DEFOR111/MADHEX-v2/Electronics/renders/PCB BOTTOM.png

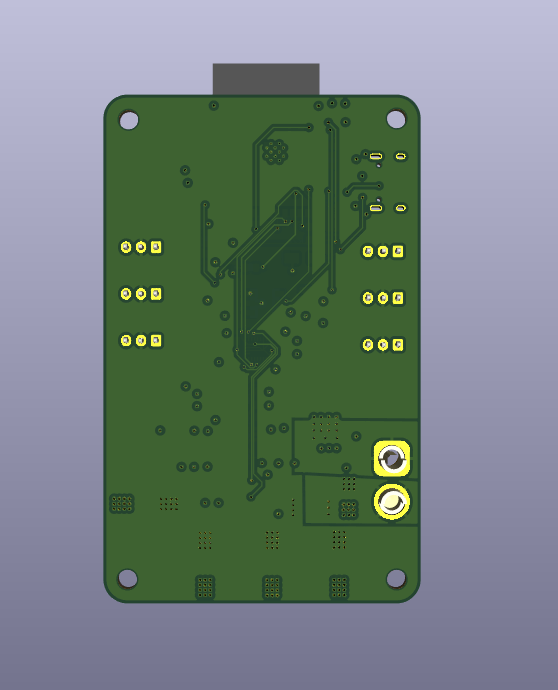
Electronics/renders/PCB BOTTOM.png
