DEFOR111/MADHEX-v2/Electronics/renders/PCB TOP VIEW.png

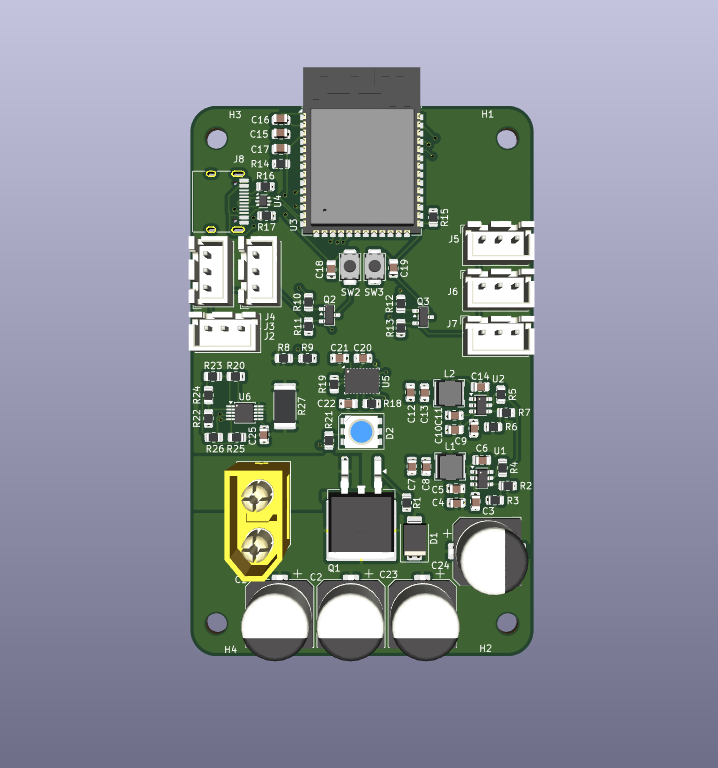
Electronics/renders/PCB TOP VIEW.png
