DEFOR111/MADHEX-v2/README.md

# ***MADHEX-v2***
> ## the Fully open source 6 legged hexapod robot 


* Custom controller PCB
* Fully open-source
* great mechanics design with amortization
#### the 18DOF hexapod robot 

## the README include 
* Overwiew
* Features
* Electronics
* CAD
* firmware
* BOM

# Overview 
MadHex v2 is an open-source hexapod robot designed for people who wanna build their spider friend and learn building — CAD, PCB , and design  are all custom-made. This repository contains everything needed to reproduce the robot: CAD source and manufacturing files, PCB design and production files, bill of materials

Currently the project is in procces of building 

# Features

* Fully custom mechanical design , all parts are 3d printable
* custom control PCB : schematics , 4 layer of layout , kicad project , and manufactoring files
* 2 Full BOM files for both PCB and Robot
* great design with beatiful decisions

 # Electronics PCB 
 ### The schematics 


### the renders
PCB LAYER F CU

PCB TOP

Custom 4-layer control board 

**Key Features :**

* **MCU:** ESP32-S3-WROOM-1 — great wifi/bluetooth MCU 
* **IMU:** BNO055  — 9-DOF orientation for balancing
* **Power input:** XT60 connector - for battery connection 
* **Power protection:** low-side N-MOSFET reverse-polarity protection NTMFS5C404NL + SMBJ10CA TVS diode + 30A fuse
* **Regulation:** two TPS563201 buck converters: battery → 5.3V → Schottky → 5V rail → 3.3V
* **USB power path:** Schottky diodes keep USB and the battery side separated
* **Power monitoring:** INA226 current/voltage sensor (I2C) with a 2m shunt + analog voltage divider as backup 
* **USB-C:**  USB with USBLC6-2P6 ESD protection
* **Status LED:**  WS2812 RGB
* **Servo interface:** 2× independent half-duplex UART buses , 3 legs per bus — driving serial bus servos over a single data line per bus instead of  PWM channels
* **Connectors:** 6 3-pin leg connectors (J2–J7), one per leg makes the wiring a lot easier 

**Files:**
* Schematic: [download the schematics](Electronics/Hexapod%20PCB%202.pdf)
* Gerbers + drill files : [Download the manufactoring files](Electronics/manufactoring%20files.zip)
* BOM: [download the PCB BOM](BOM-PCB.csv)

**Board spec:**

| Spec | Value |
|---|---|
| Layers | 4 |
| MCU | ESP32-S3-WROOM-1 |
| Logic  | 3.3V |
| Peripheral  | 5V |
| Servo buses | 2× half-duplex UART (3 legs each) |
| Power input | XT60 |
| Current sensing | INA226 |

# CAD

Fully custom mechanical design, designed in autodesk Fusion every part is 3D-printable 



**values:**

| Spec | Value |
|---|---|
| size | 600 × 175 mm |
| DOF per leg | 3 (coxa – femur – tibia) |
| Total DOF | 18 |
| Coxa (axis to axis) | 45 mm |
| Femur (axis to axis) | 128 mm |
| Tibia (knee axis to foot tip) | 141.8 mm straight line, 168.5 mm along the curved part |
| Actuators | LX-16A serial bus servo, 17 kg·cm at 6V / 19.5 kg·cm at 7.4V (×18) |

Segment lengths were chosen using the servo torque  

**3D printing:**

| Spec | Value |
|---|---|
| Material | PETG |
| Total printed weight | ~878–950 g (all parts, with supports) |
| Parts | download [3d printing STL parts ](CAD/STL(3d%20printing%20parts)) |

PETG was chosen over PLA for better impact resistance sustained servo load — legs take repeated ground-impact stress during walking.

**Foot amortization (printed spring):**

Each foot includes a printed compliant spring element (PETG) acting as a passive shock absorber — it absorbs ground-impact impulse on footfall instead of transmitting it directly into the leg linkage/servo horn, reducing mechanical stress and jitter during walking.

**Files:**

| Format | Path | Use case |
|---|---|---|
| `.f3d` / `.f3z` | [autodesk fusion source file](CAD/source(f3d)) | Editable native Fusion source |
| `.step` | [full robot design universal file](CAD/step) | Full assembly + parts, universal format |
| `.stl` | [3d printing files](CAD/STL(3d%20printing%20parts)) | ready to slice |
| Renders | [photos of the CAD](CAD/renders) | Reference images |

Full parts list, printed vs. purchased components, and quantities: [see the main BOM](BOM%20main.csv)

# Bill of Materials

Two separate BOMs are provided — one for the full robot, one for the PCB only.

### Full Robot BOM

Full file: [see the full main BOM](BOM%20main.csv)

| Item | Qty | Description | Price |
|---|---|---|---|
| PCB | 1 | Custom PCB, UART servo controller — see [PCB BOM](BOM-PCB.csv) below | $50.10 |
| LX-16A | 18 | Serial bus UART servo, 17 kg·cm @6V / 19.5 kg·cm @7.4V | $252.00 |
| Battery | 1 | 6000mAh 2S, 7.4–8.4V, ≥30A discharge | $29.70 |
| Auto Fuse + holder | 1 | 30A safety fuse | $5.31 |
| XT60 | 1 | Pack of male/female connectors | $2.00 |
| Power wire | — | Silicone 14 AWG, battery → PCB | — |
| PETG | 900g | Filament for 3D-printed parts (min. 900g) | — |
| M3 screws | pack | Structural assembly | — |
| M3×5 inserts | pack | Heat-set inserts, structural assembly | — |
| M2 screws | pack | Servo mounting | — |
| Wires | pack | Electronics wiring | — |
| PCB manufacturing | 1 | Bare PCB fab, green solder mask | $14.00 |
| **Total** | | *incl. VAT, delivery, components* | **$420** |

### PCB BOM

Full file: [see the full PCB BOM](BOM-PCB.csv)

| Ref Des | Qty | Description | Value | Footprint | Price (unit) |
|---|---|---|---|---|---|
| C1, C2, C23, C24 | 4 | Electrolytic cap | 1000µF 16V | CP_Elec 10×10mm | $2.23 |
| C3, C4, C9, C10 | 4 | Ceramic cap | 10µF 25V | 0805 | $1.21 |
| C5, C6, C11, C14, C16, C18–C22, C25, C26 | 12 | Ceramic cap | 0.1µF 100V | 0805 | $0.91 |
| C7, C8, C12, C13, C15 | 5 | Ceramic cap | 22µF 25V | 0805 | $1.68 |
| C17 | 1 | Ceramic cap | 1µF 50V | 0805 | $1.08 |
| D1 | 1 | TVS diode, bidirectional | SMBJ10CA | SMB | $0.55 |
| D2 | 1 | RGB LED | WS2812B | PLCC-6 | $0.52 |
| D3, D4 | 2 | Schottky diode 3A 40V | SS34 | SMA | $0.70 |
| D5 | 1 | Zener diode 12V | BZT52C12 | SOD-123 | $0.56 |
| J1 | 1 | Battery connector | XT60-M, PCB mount | AMASS XT60-M | $0.38 |
| J2–J7 | 6 | Servo bus connector (leg1–leg6) | 3-pin 2.5mm JST XH | JST_XH_B3B | $0.55 |
| J8 | 1 | USB-C receptacle | USB 2.0, 16-pin | HRO TYPE-C-31-M-12 | $0.86 |
| L1 | 1 | Power inductor | 3.3µH | SRN4018 | $0.59 |
| L2 | 1 | Power inductor | 2.2µH | SRN4018 | $1.76 |
| Q1 | 1 | N-MOSFET, reverse polarity protection | NTMFS5C404NLT1G | DFN-5 5×6 | $2.62 |
| Q2, Q3 | 2 | NPN transistor, half-duplex | MMBT3904 | SOT-23 | $0.72 |
| R1, R3–R6, R14, R15, R18–R20, R22 | 11 | Resistor | 10k | 0805 | $0.45 |
| R2 | 1 | Resistor | 59k | 0805 | $0.41 |
| R7, R9 | 2 | Resistor | 33k | 0805 | $0.45 |
| R8, R28 | 2 | Resistor | 100k | 0805 | $0.45 |
| R10, R12, R24, R29 | 4 | Resistor | 1k | 0805 | $0.45 |
| R11, R13, R25, R26 | 4 | Resistor | 4.7k | 0805 | $0.45 |
| R16, R17 | 2 | Resistor | 5.1k | 0805 | $0.45 |
| R21 | 1 | Resistor | 330R | 0805 | $0.45 |
| R23 | 1 | Shunt resistor 2mΩ 1% 5W | Bourns CSS2H-2512K-2L00F | 2512 | $0.80 |
| SW2, SW3 | 2 | Tactile button | TS-1088 | SMD | $0.64 |
| U1, U2 | 2 | Buck converter | TPS563201 | SOT-23-6 | $0.78 |
| U3 | 1 | MCU module (8MB flash, no PSRAM) | ESP32-S3-WROOM-1-N8 | SMD module | $4.91 |
| U4 | 1 | ESD protection | USBLC6-2P6 | SOT-666 | $1.33 |
| U5 | 1 | 9-axis IMU | BNO055 | LGA-28 | $9.41 |
| U6 | 1 | Current/voltage monitor | INA226 | TSSOP-10 | $0.83 |
| **Total (per board)** | | *incl. LCSC + AliExpress delivery, 16% VAT, shipping* | | **$49.87** |

# Firmware

Written in C++ with PlatformIO (Arduino framework) for the ESP32-S3

**Features:**

* **Inverse kinematics** from the CAD joint points, with joint limits
* **Gaits:** ripple (default), tripod and wave
* **Movement:** forward, backward, sideways, turning in place, combined; adjustable body height
* **States:** sit, stand up, stand, walk, sit down, emergency stop
* **Safe startup:** servo output is off after power-up; when enabled, it reads every servo position and moves slowly to the sitting pose
* **Calibration:** trim and direction for each of the 18 servos
* **Safety:** low battery, servo overheating, emergency stop, stop on lost Wi-Fi link
* **Sensors:** INA226 current and voltage, BNO055 orientation, optional body leveling
* **Status LED:** a color for each robot state
* **Tests:** 200+ unit tests that run on a PC without hardware

**Pinout:**

| Function | GPIO |
|---|---|
| Servo bus 1 TX / RX (legs A, B, F) | 4 / 5 |
| Servo bus 2 TX / RX (legs C, D, E) | 17 / 18 |
| I2C SDA / SCL (INA226 0x40, BNO055 0x28) | 8 / 9 |
| Battery voltage (ADC) | 1 |
| WS2812 data | 7 |
| BNO055 reset / interrupt | 10 / 11 |
| USB D− / D+ | 19 / 20 |

**Build and flash** (VS Code + PlatformIO):

```
cd Firmware
pio test -e native        # unit tests on the PC
pio run -t upload         # flash the ESP32-S3 over USB-C
pio run -t uploadfs       # upload the web control page
```
a bit about the project history : i always wanted to make the hexapod but had no skills so 1 year passed i got pretty good skills in cad electronics and etc so now this project is real
