DEFOR111/MADHEX-v2/CAD/renders/amortzation sprint view.png

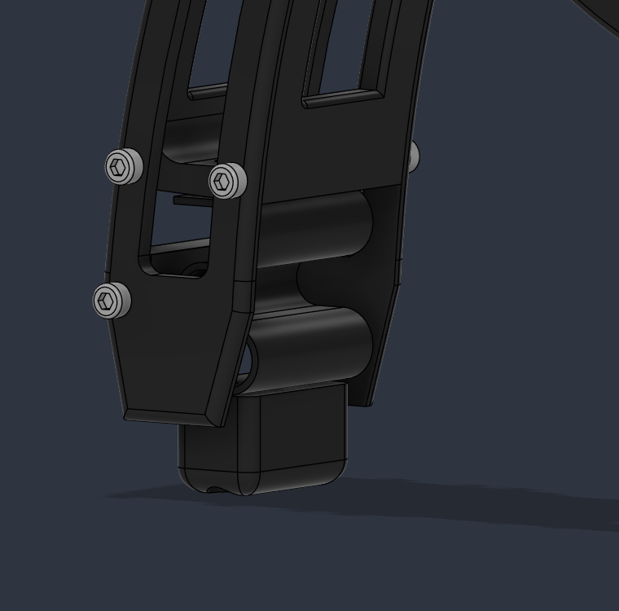
CAD/renders/amortzation sprint view.png
