DEFOR111/MADHEX-v2/CAD/renders/bottom view.png

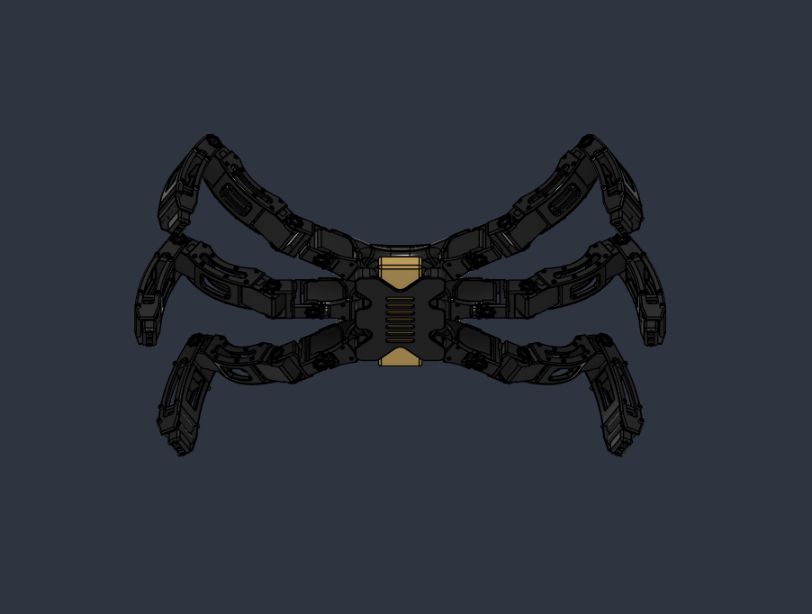
CAD/renders/bottom view.png
