DEFOR111/MADHEX-v2/CAD/renders/front view.png

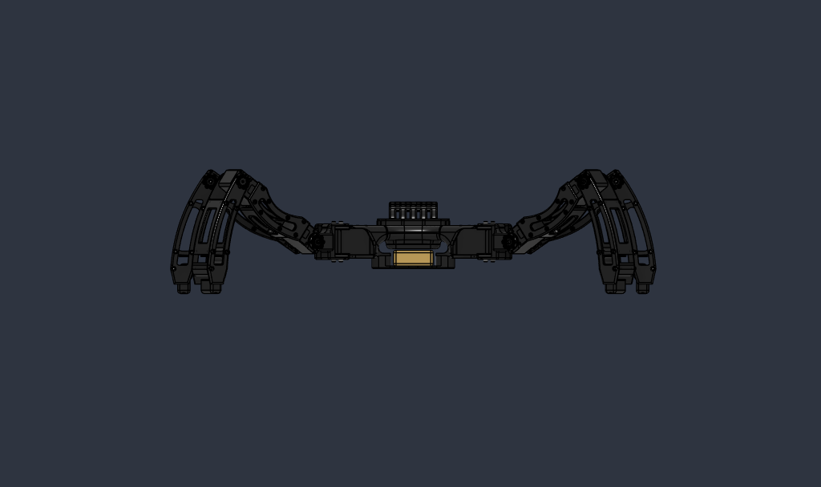
CAD/renders/front view.png
