DEFOR111/MADHEX-v2/CAD/renders/seperate leg view.png

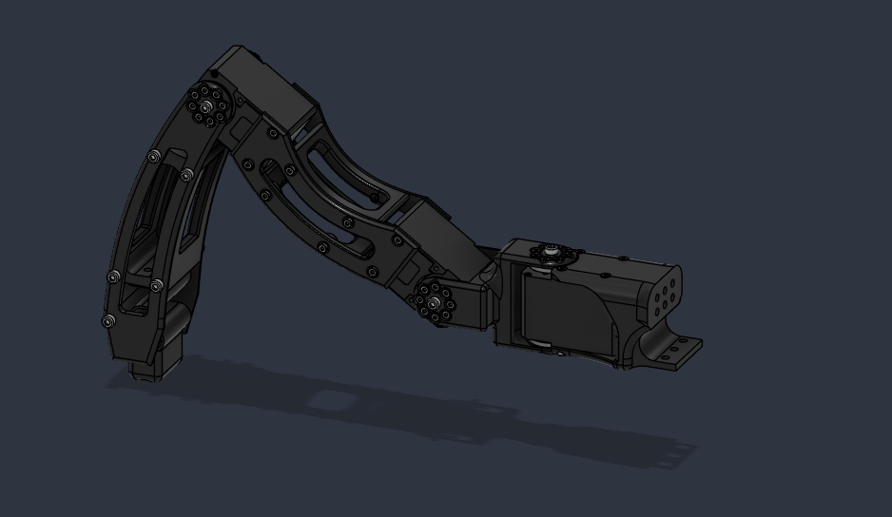
CAD/renders/seperate leg view.png
