DEFOR111/MADHEX-v2/CAD/renders/side view.png

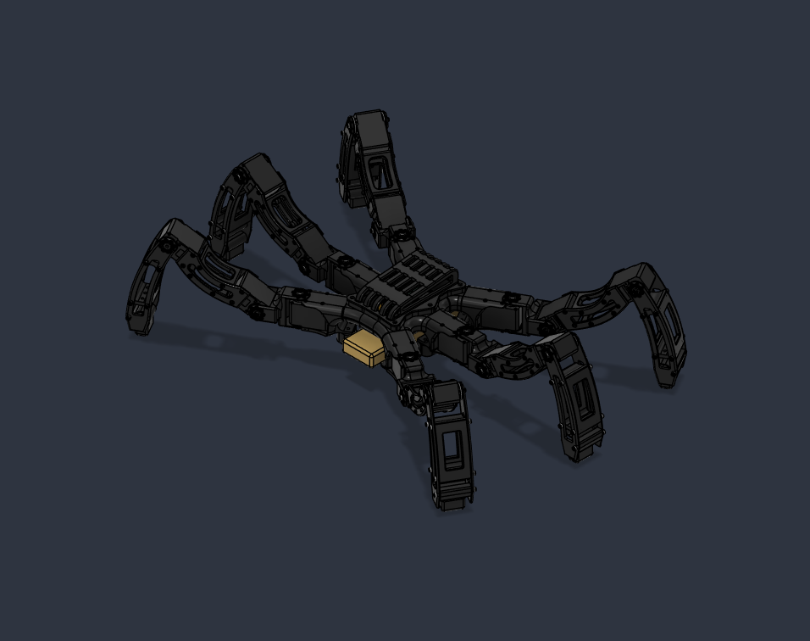
CAD/renders/side view.png
