DEFOR111/MADHEX-v2/CAD/renders/top view.png

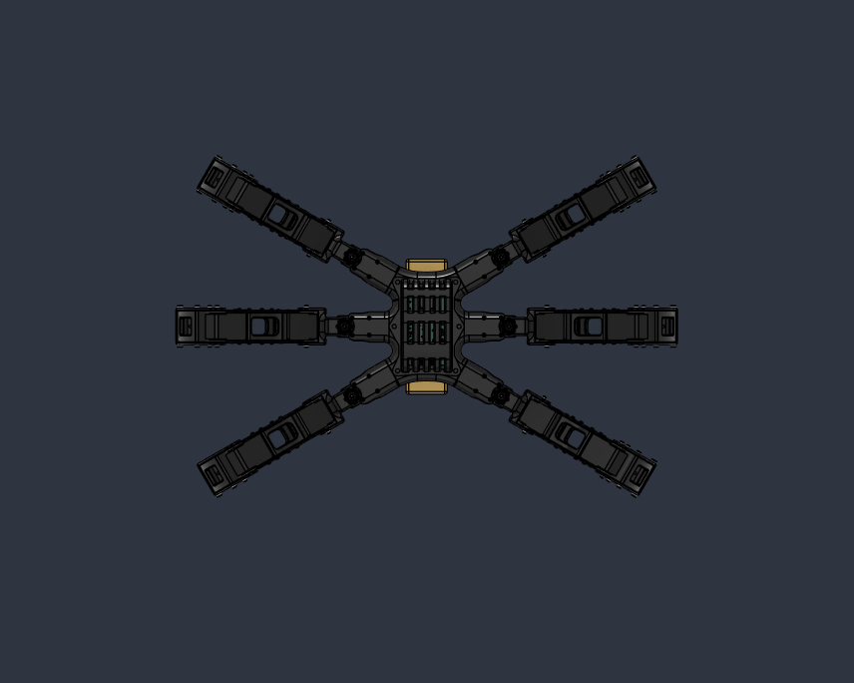
CAD/renders/top view.png
