DEFOR111/MADHEX-v2/Electronics/renders/B.cu layer.png

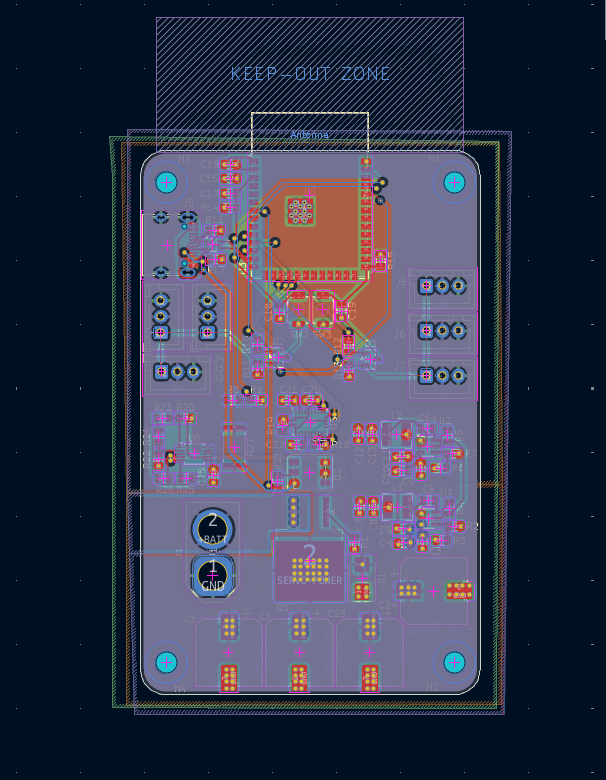
Electronics/renders/B.cu layer.png
