DEFOR111/MADHEX-v2/Electronics/renders/F.cu layer.png

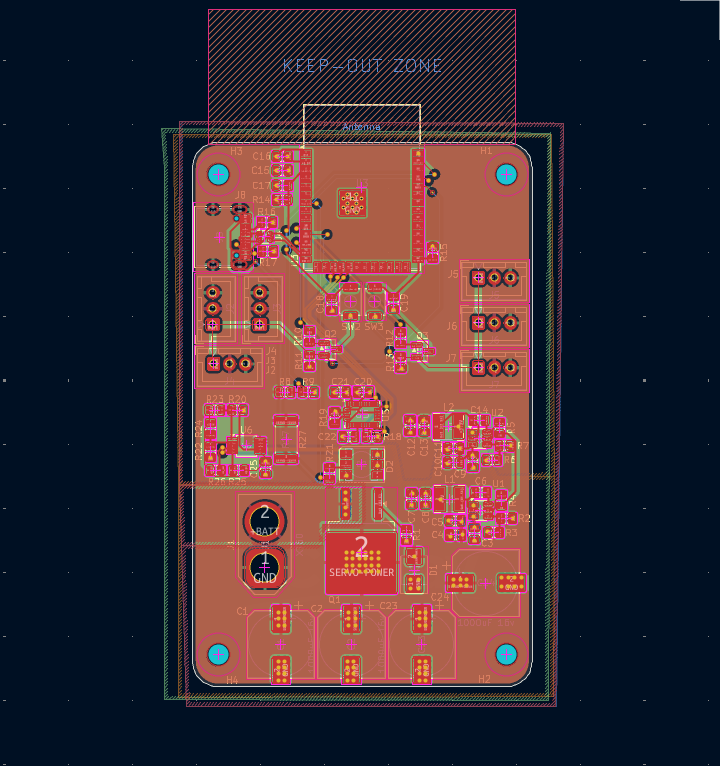
Electronics/renders/F.cu layer.png
