DEFOR111/MADHEX-v2/Electronics/renders/in1.cu layer.png

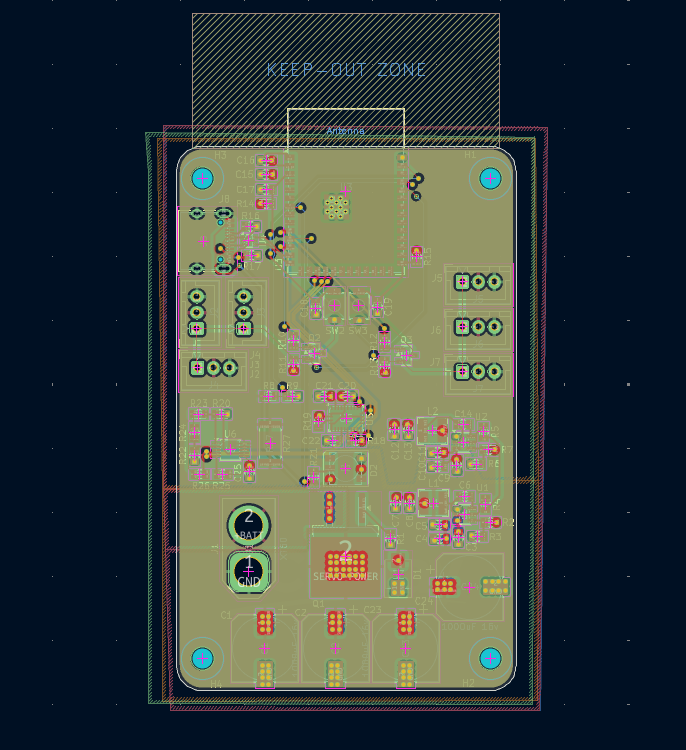
Electronics/renders/in1.cu layer.png
