DEFOR111/MADHEX-v2/Electronics/renders/in2.cu layer.png

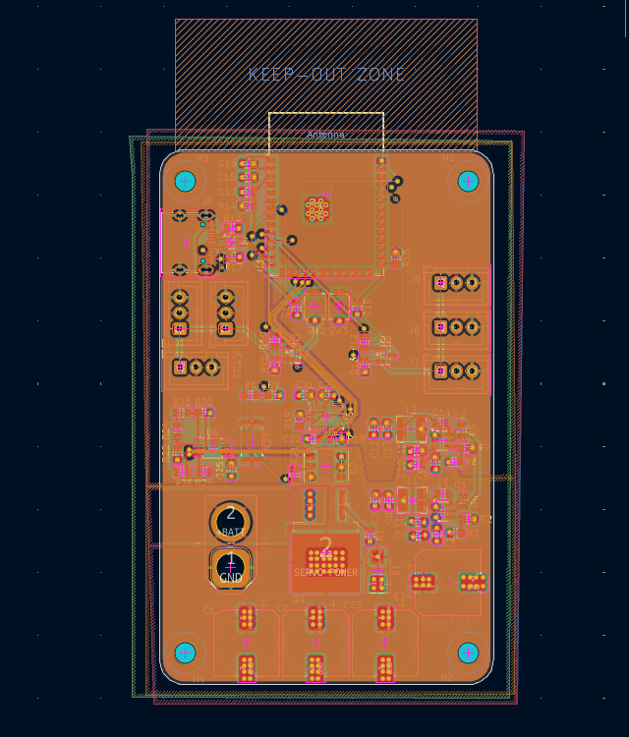
Electronics/renders/in2.cu layer.png
