DEFOR111/MADHEX-v2/Electronics/renders/PCB BOTTOM VIEW.png

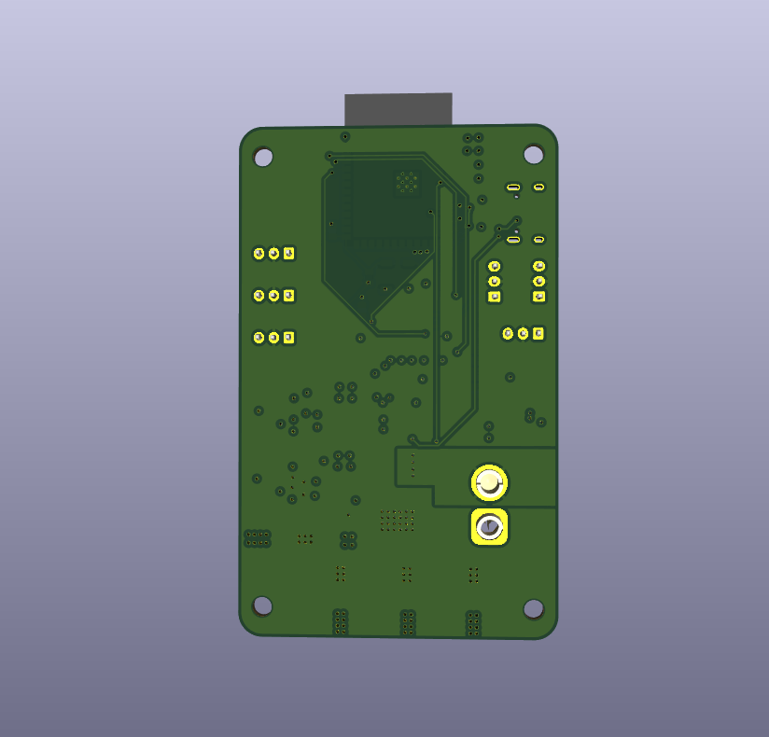
Electronics/renders/PCB BOTTOM VIEW.png
