DEFOR111/MADHEX-v2/Electronics/renders/PCB LAYER B.CU.png

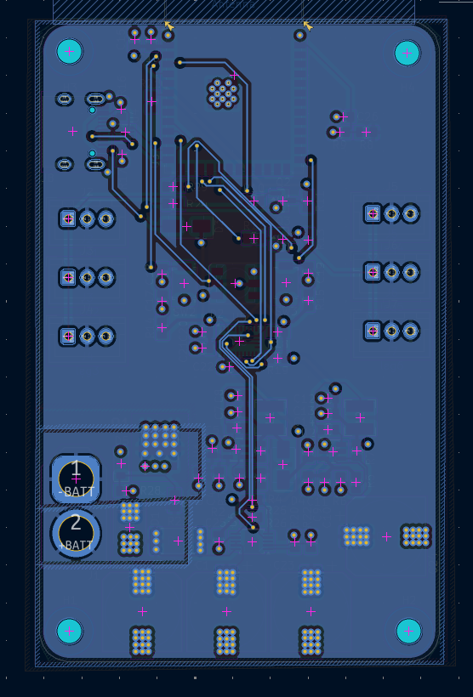
Electronics/renders/PCB LAYER B.CU.png
