DEFOR111/MADHEX-v2/Electronics/renders/PCB LAYER F.CU.png

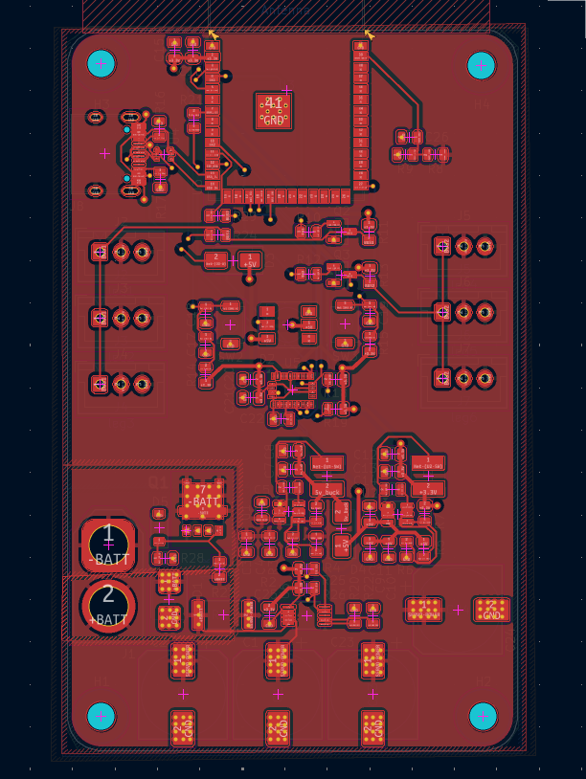
Electronics/renders/PCB LAYER F.CU.png
