DEFOR111/MADHEX-v2/Electronics/renders/PCB LAYER IN1.CU.png

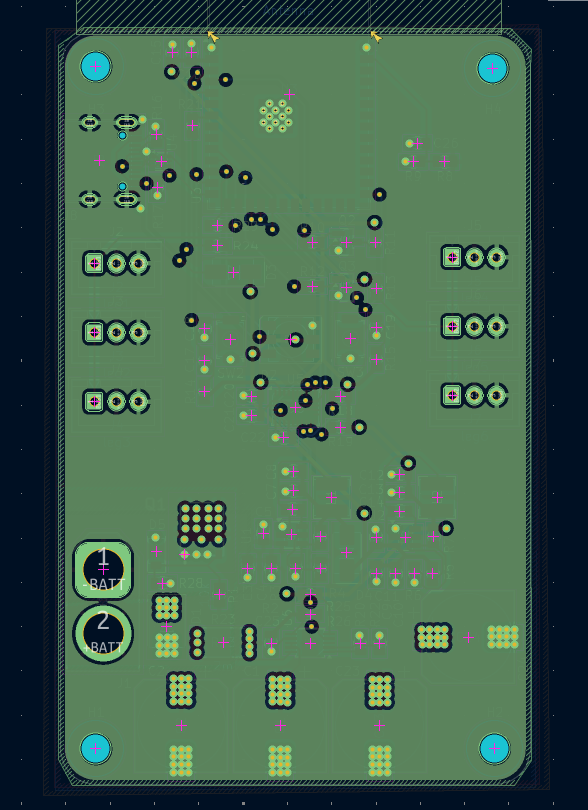
Electronics/renders/PCB LAYER IN1.CU.png
