DEFOR111/MADHEX-v2/Electronics/renders/PCB LAYER IN2.CU.png

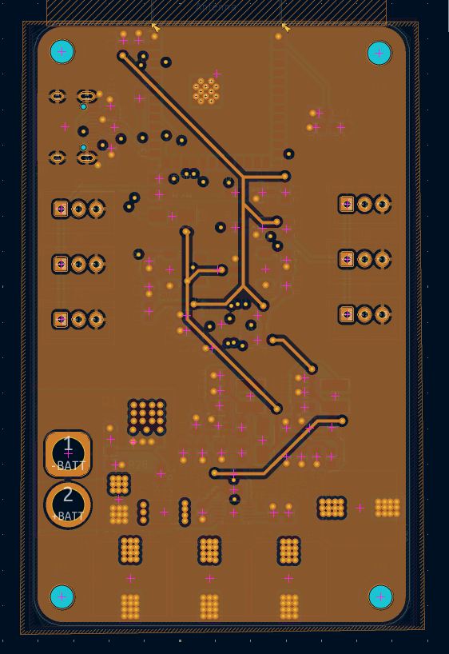
Electronics/renders/PCB LAYER IN2.CU.png
