DEFOR111/MADHEX-v2/Electronics/renders/PCB SIDE.png

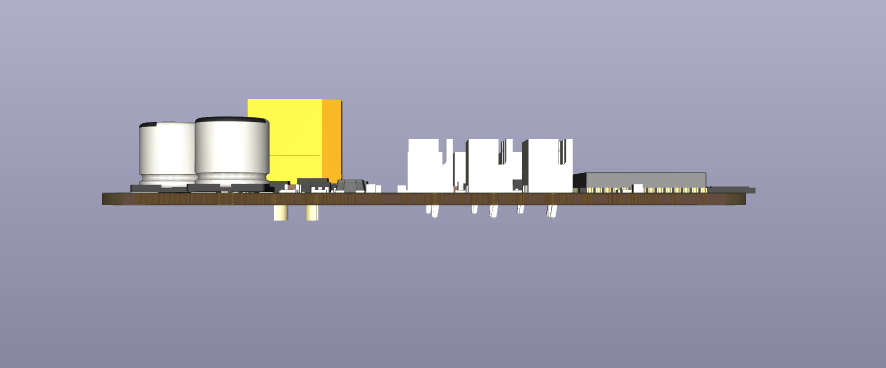
Electronics/renders/PCB SIDE.png
