DEFOR111/MADHEX-v2/Electronics/renders/PCB TOP.png

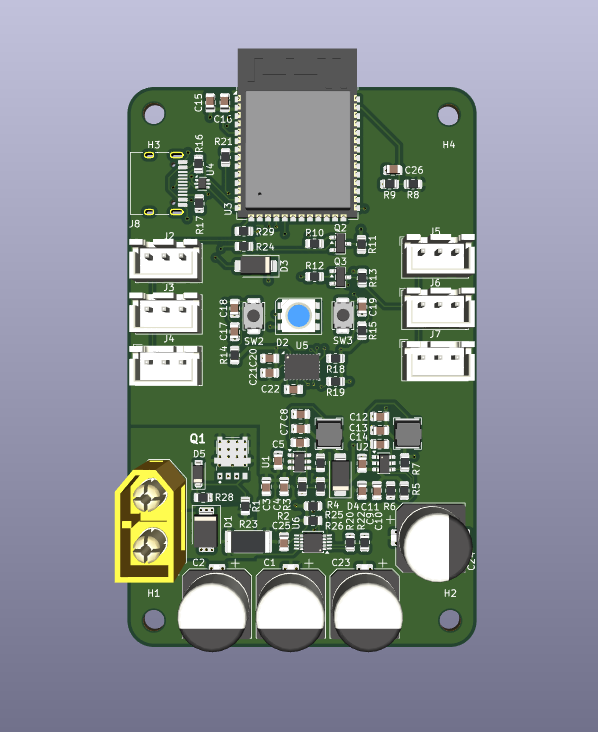
Electronics/renders/PCB TOP.png
