DEFOR111/MADHEX-v2/BOM main.csv

name | qty | description | link | price
PCB | 1 | custom PCB UART servo controller | you will find the BOM for PCB as "BOM-PCB" | 50.1$
LX-16A | 18 | serial bus UART servos | https://aliexpress.ru/item/1005005028413207.html?sku_id=12000031385600109 | 252$
battery | 1 | 6000mAh 2S 7.4-8.4v battery | https://aliexpress.ru/item/1005002310526294.html?sku_id=12000020028223874 | 29.7$
auto FUSE | 1 | 30A safe fuse | https://aliexpress.ru/item/1005006286934036.html?sku_id=12000036617728281 | 5.31$
XT60 | 1 | pack of XT60 male/female for connection | https://aliexpress.ru/item/1005003628675139.html?sku_id=12000026563681135 | 2$
PETG | 900g | for 3d printing parts at least 900g | - | -
M3 scrwew | pack | for connecting parts | - | -
M3D5 inserts | pack | for connecting parts | - | -
M2 screws | pack | for servo connection | - | -
wires | pack | for connecting electronics | - | -
PCB manufactoring | only green PCB | pcb | - | 14$
 |  |  | VAT+delivery+components | Total:420$
