DEFOR111/MADHEX-v2/docs/hexapod_pcb_bom.csv

Hexapod Controller — BOM
Qty (boards):
Ref Des | Qty/bd | Total Qty | Description | Value | Footprint | link | price
C1,C2,C23,C24 | 4 | 10 | Cap, electrolytic | 1000uF 16V | CP_Elec 10x10mm | https://aliexpress.ru/item/1005002964957462.html?sku_id=12000022993660173 | 2.23$
C3,C4,C9,C10 | 4 | 100 | Cap ceramic | 10uF 25v | 0805 | https://aliexpress.ru/item/1005009339427569.html?sku_id=12000048878731086 | 1.21$
C5,C6,C11,C14,C16,C18,C19,C20,C21,C22,C25 | 11 | 100 | Cap ceramic | 0.1uF 100v | 0805 | https://aliexpress.ru/item/1005009339427569.html?sku_id=12000048878731064 | 0.91$
C7,C8,C12,C13,C15 | 5 | 50 | Cap ceramic | 22uF 25v | 0805 | https://aliexpress.ru/item/1005008523091680.html?sku_id=12000045550598829 | 1.68$
C17 | 1 | 100 | Cap ceramic | 1uF 50v | 0805 | https://aliexpress.ru/item/1005009339427569.html?sku_id=12000048878731073 | 1.08$
D1 | 1 | 5 | TVS diode | SMBJ10A 10V | SMB | https://www.lcsc.com/product-detail/C148210.html | 0.59$
D2 | 1 | 5 | RGB LED | WS2812B | PLCC-6 5.0x5.0mm P1.6mm | https://www.lcsc.com/product-detail/C114586.html?s_z=n_q_t_WS2812B | 0.52$
J1 | 1 | 0 | Battery connector | XT60-M PCB mount | AMASS XT60-M 1x02 P7.20mm Vertical | https://www.lcsc.com/product-detail/C5334533.html | 0.38$
J2-J7 | 6 | 0 | Servo bus connector leg1-leg6 | 3-pin 2.5mm (JST XH) | JST_XH_B3B-XH-A_1x03_P2.50mm_Vertical | https://www.lcsc.com/product-detail/C144394.html?s_z=n_q_C144394&globalKeyword=C144394 | 0.55$
J8 | 1 | 0 | USB-C receptacle | USB2.0 16-pin | HRO TYPE-C-31-M-12 | https://www.lcsc.com/product-detail/C165948.html?s_z=n_q_C165948&globalKeyword=C165948 | 0.86$
L1 | 1 | 0 | Power inductor | 3.3uH | SRN4018 | https://www.lcsc.com/product-detail/C19947635.html?s_z=n_q_SRN4018%25203R3M | 0.59$
L2 | 1 | 5 | Power inductor | 2.2uH | SRN4018 | https://www.lcsc.com/product-detail/C913207.html | 1.76$
Q1 | 1 | 0 | P-MOSFET | IRF4905 | TO-263-2 | https://www.lcsc.com/product-detail/C2620.html?s_z=n_q_c2620&globalKeyword=c2620 | 1.1$
Q2,Q3 | 2 | 50 | transistor half-duplex | JSCJ 2N7002 | SOT-23 | https://www.lcsc.com/product-detail/C8545.html?s_z=n_q_c8545&globalKeyword=c8545 | 0.89$
R1 | 1 | 100 | Resistor | 100k | 0805 | https://aliexpress.ru/item/1005009887091465.html?sku_id=12000050482999184 | 0.45$
R2 | 1 | 100 | Resistor | 54.9k | 0805 | https://aliexpress.ru/item/1005009887091465.html?sku_id=12000050482999178 | 0.45$
R3,R4,R5,R6,R14,R15,R18,R19,R20,R22,R23,R24 | 12 | 100 | Resistor | 10k | 0805 | https://aliexpress.ru/item/1005009887091465.html?sku_id=12000050482999160 | 0.45$
R7,R9 | 2 | 100 | Resistor | 33k | 0805 | https://aliexpress.ru/item/1005009887091465.html?sku_id=12000050482999172 | 0.45$
R8 | 1 | 100 | Resistor | 51k | 0805 | https://aliexpress.ru/item/1005009887091465.html?sku_id=12000050482999177 | 0.45$
R10,R12 | 2 | 100 | Resistor | 1k | 0805 | https://aliexpress.ru/item/1005009887091465.html?sku_id=12000050482999136 | 0.45$
R11,R13,R25,R26 | 4 | 100 | Resistor | 4.7k | 0805 | https://aliexpress.ru/item/1005009887091465.html?sku_id=12000050482999152 | 0.45$
R16,R17 | 2 | 100 | Resistor | 5.1k | 0805 | https://aliexpress.ru/item/1005009887091465.html?sku_id=12000050482999153 | 0.45$
R21 | 1 | 100 | Resistor | 330R | 0805 | https://aliexpress.ru/item/1005009887091465.html?sku_id=12000050482999124 | 0.45$
R27 | 1 | 20 | Shunt resistor | 2mR | 2512 | https://aliexpress.ru/item/1005012015238252.html?sku_id=12000057293682538 | 2.43$
SW2,SW3 | 2 | 10 | Tactile button | TS-1088 | SMD | https://www.lcsc.com/product-detail/C455280.html?s_z=n_q_ts-1088 | 0.64$
U1,U2 | 2 | 10 | Buck converter | TPS563201 | SOT-23-6 | https://www.lcsc.com/product-detail/C116592.html?s_z=n_q_C116592&globalKeyword=C116592 | 0.78$
U3 | 1 | 0 | MCU module | ESP32-S3-WROOM-1 | SMD module | https://www.lcsc.com/product-detail/C2913198.html?s_z=n_q_C2913198&globalKeyword=C2913198 | 4.91$
U4 | 1 | 0 | ESD protection | USBLC6-2P6 | SOT-666 | https://www.lcsc.com/product-detail/C15999.html?s_z=n_q_c15999&globalKeyword=c15999 | 1.33$
U5 | 1 | 0 | 9-axis IMU | BNO055 | LGA-28 3.8x5.2mm | https://www.lcsc.com/product-detail/C93216.html?s_z=n_q_C93216&globalKeyword=C93216 | 9.41$
U6 | 1 | 0 | Current/voltage monitor | INA226 | TSSOP-10 | https://www.lcsc.com/product-detail/C49851.html?s_z=n_q_C49851&globalKeyword=C49851 | 0.83$
 |  |  |  |  | LCSC+ALIEXPRESS+DELIVERY+16% VAT+SHIPPING |  | TOTAL: 56.1$
