DEFOR111/MADHEX-v2/CAD/STL(3d printing parts)/amortization spring.stl

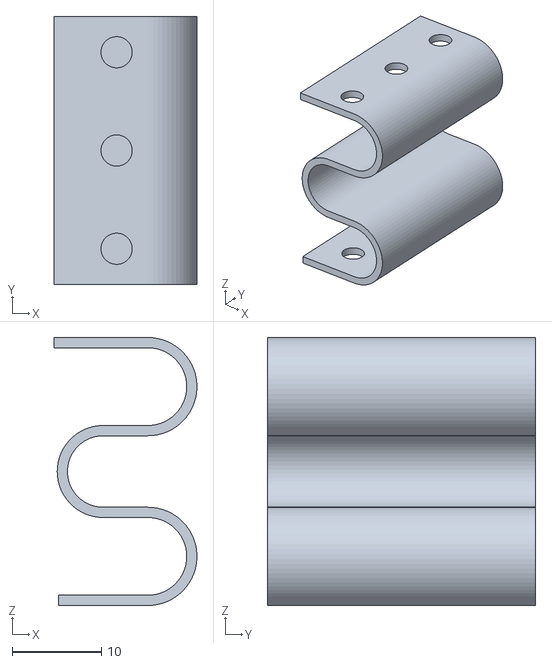
[picture p20: CAD file, 2026-09-05]
CAD/STL(3d printing parts)/amortization spring.stl
16.0 x 30.0 x 30.0
