DEFOR111/MADHEX-v2/CAD/STL(3d printing parts)/tibia left part.stl

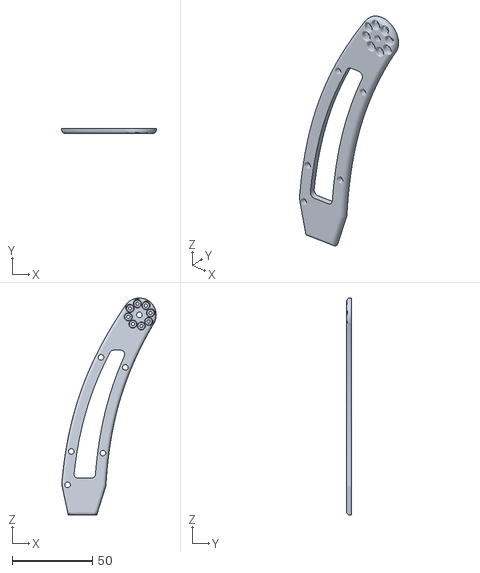
[picture p21: CAD file, 2026-09-05]
CAD/STL(3d printing parts)/tibia left part.stl
58.8 x 3.00 x 134.9
