DEFOR111/MADHEX-v2/CAD/STL(3d printing parts)/tibia central part.stl

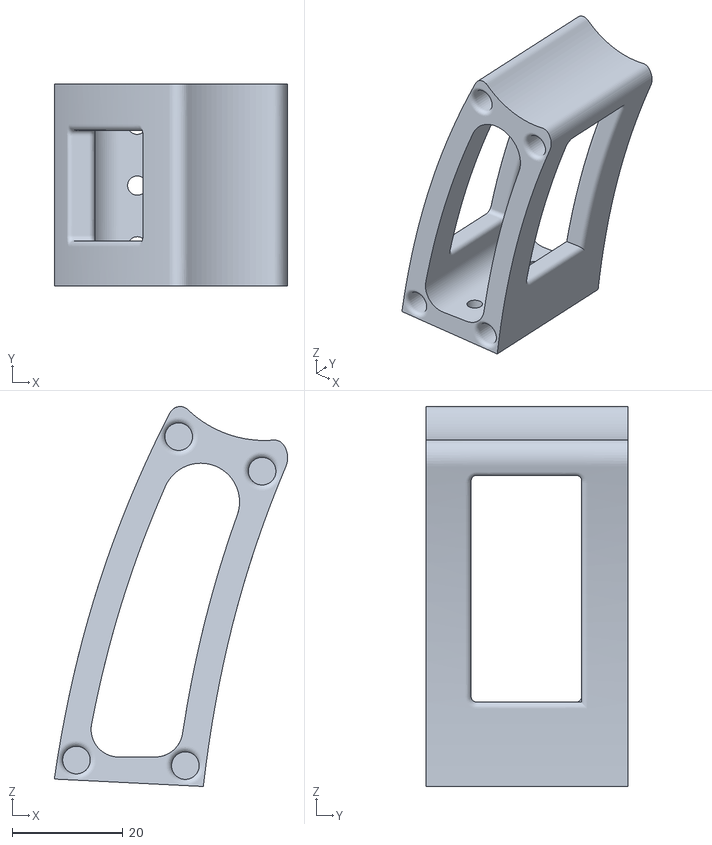
[picture p22: CAD file, 2026-09-05]
CAD/STL(3d printing parts)/tibia central part.stl
42.2 x 36.5 x 68.7
