DEFOR111/MADHEX-v2/CAD/STL(3d printing parts)/leg foot.stl

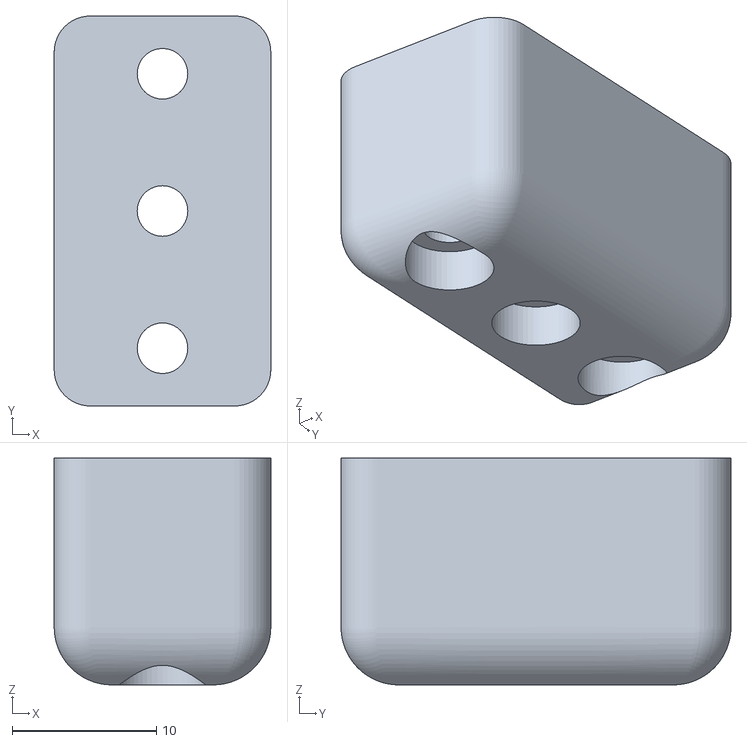
[picture p23: CAD file, 2026-09-05]
CAD/STL(3d printing parts)/leg foot.stl
15.0 x 27.0 x 15.7
