DEFOR111/MADHEX-v2/CAD/STL(3d printing parts)/femur left part.stl

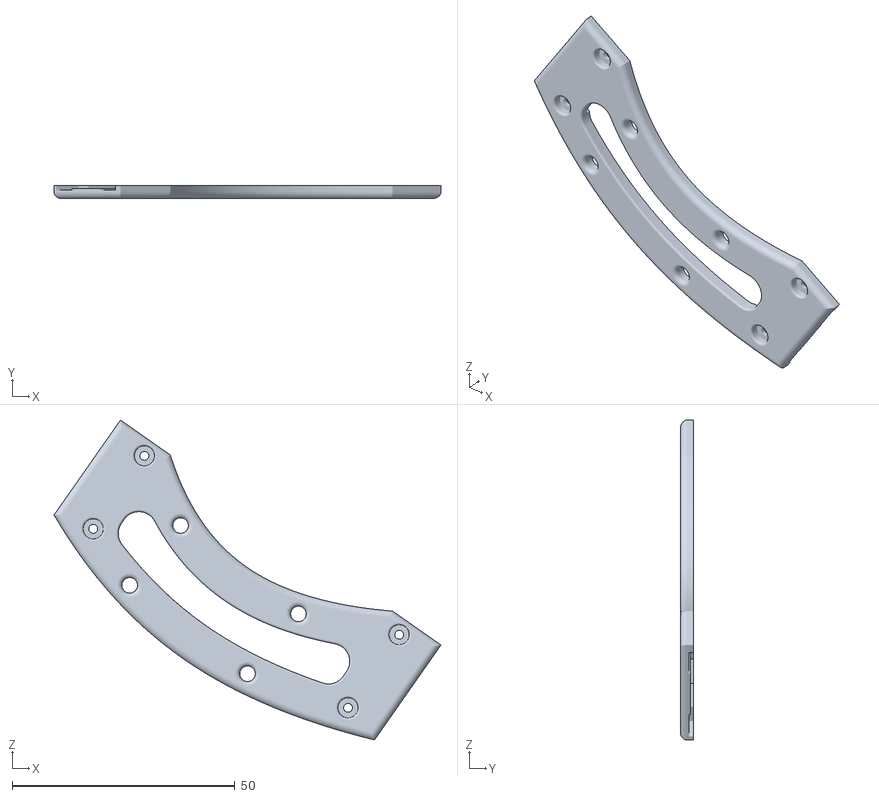
[picture p24: CAD file, 2026-09-05]
CAD/STL(3d printing parts)/femur left part.stl
86.8 x 3.00 x 71.8
