DEFOR111/MADHEX-v2/CAD/STL(3d printing parts)/coxa-femur mount.stl

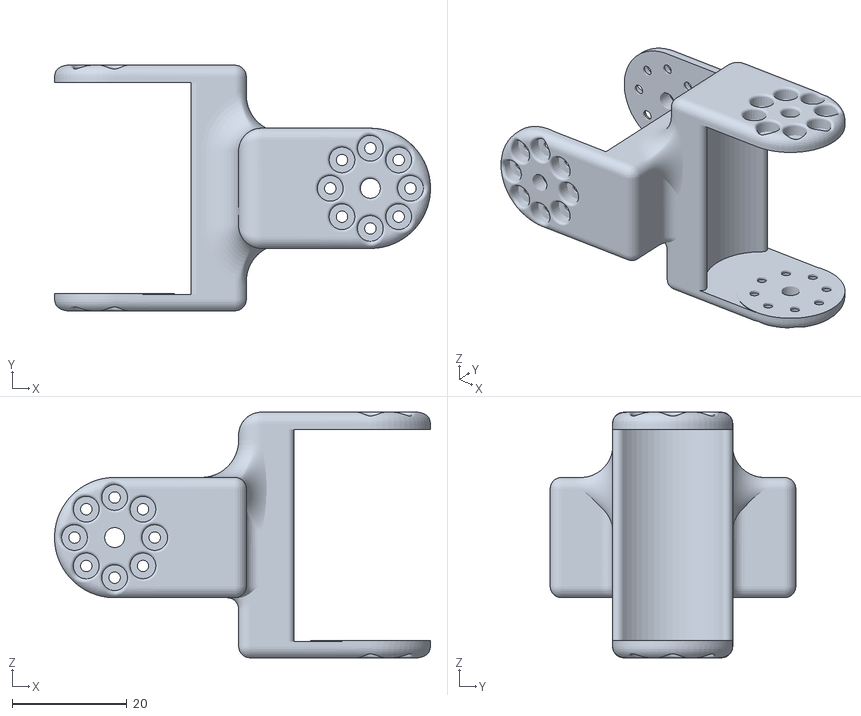
[picture p25: CAD file, 2026-09-05]
CAD/STL(3d printing parts)/coxa-femur mount.stl
65.6 x 42.9 x 42.9
