DEFOR111/MADHEX-v2/CAD/STL(3d printing parts)/femur cental bottom part.stl

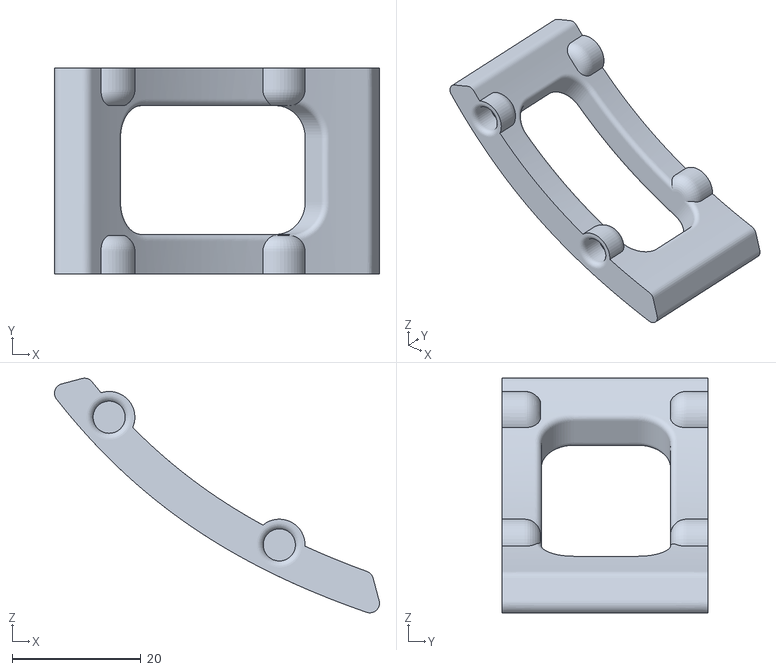
[picture p26: CAD file, 2026-09-05]
CAD/STL(3d printing parts)/femur cental bottom part.stl
50.5 x 32.0 x 36.4
