DEFOR111/MADHEX-v2/CAD/STL(3d printing parts)/coxa servo holder 30.stl

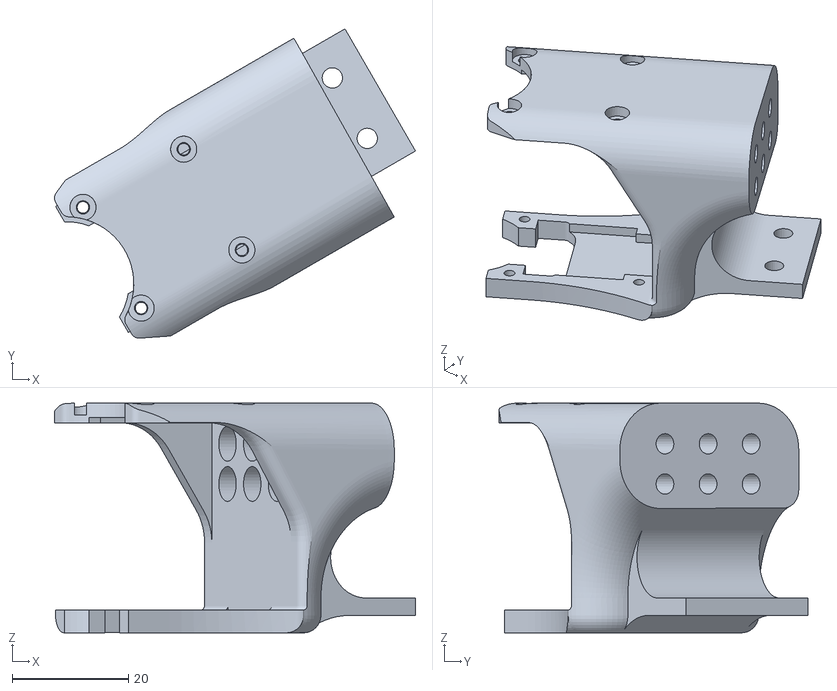
[picture p27: CAD file, 2026-09-05]
CAD/STL(3d printing parts)/coxa servo holder 30.stl
62.1 x 53.2 x 39.5
