DEFOR111/MADHEX-v2/CAD/STL(3d printing parts)/femur cental top part.stl

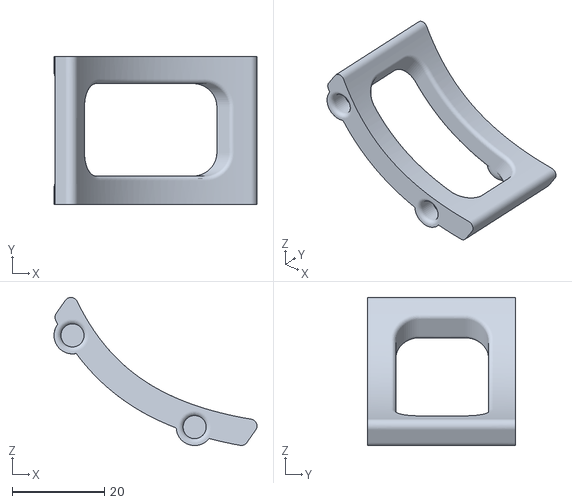
[picture p28: CAD file, 2026-09-05]
CAD/STL(3d printing parts)/femur cental top part.stl
43.9 x 32.0 x 32.0
