DEFOR111/MADHEX-v2/CAD/STL(3d printing parts)/central case cap.stl

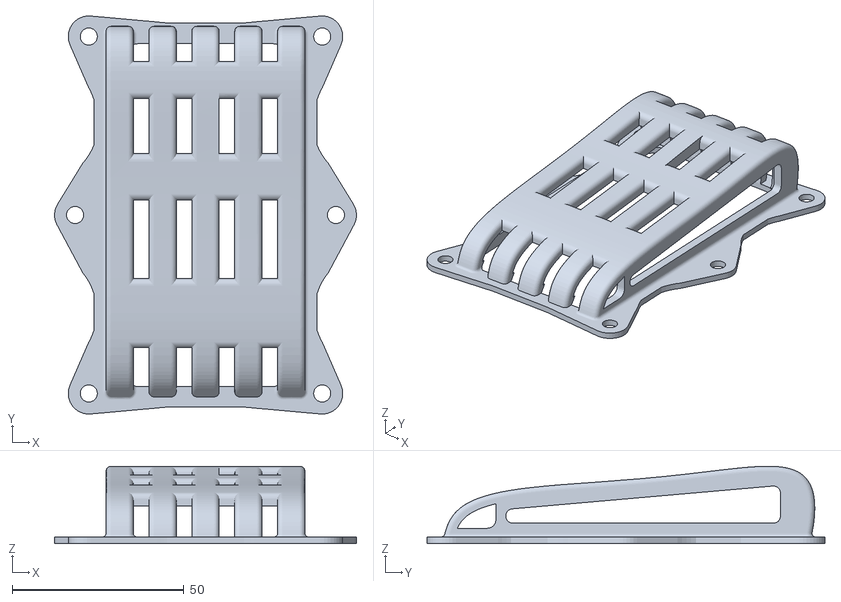
[picture p29: CAD file, 2026-09-05]
CAD/STL(3d printing parts)/central case cap.stl
88.0 x 116.0 x 22.6
