DEFOR111/MADHEX-v2/CAD/STL(3d printing parts)/cental case.stl

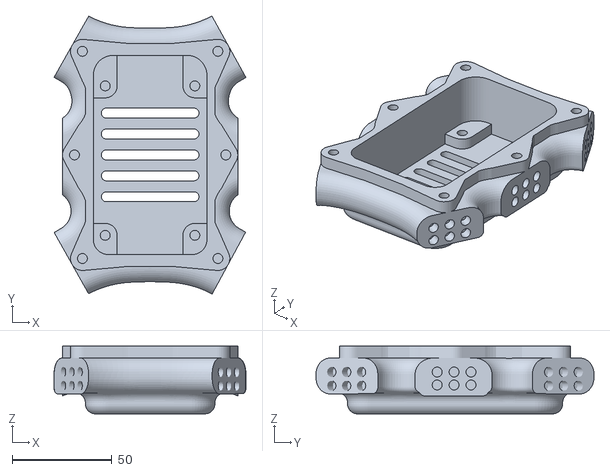
[picture p30: CAD file, 2026-09-05]
CAD/STL(3d printing parts)/cental case.stl
96.3 x 139.5 x 34.0
