DEFOR111/MADHEX-v2/CAD/STL(3d printing parts)/tibia spting cover.stl

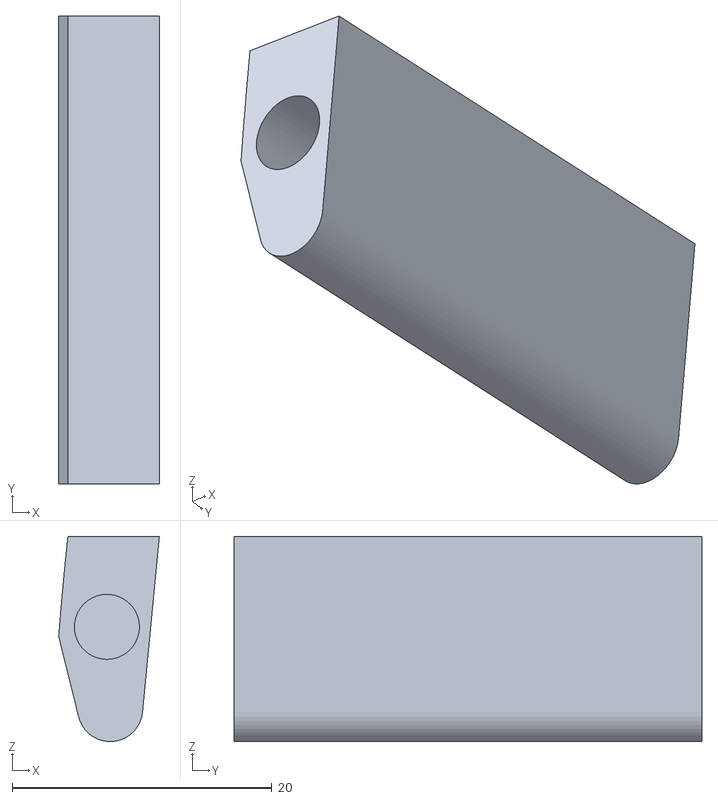
[picture p31: CAD file, 2026-09-05]
CAD/STL(3d printing parts)/tibia spting cover.stl
7.75 x 36.0 x 15.8
