DEFOR111/MADHEX-v2/CAD/STL(3d printing parts)/battery holder.stl

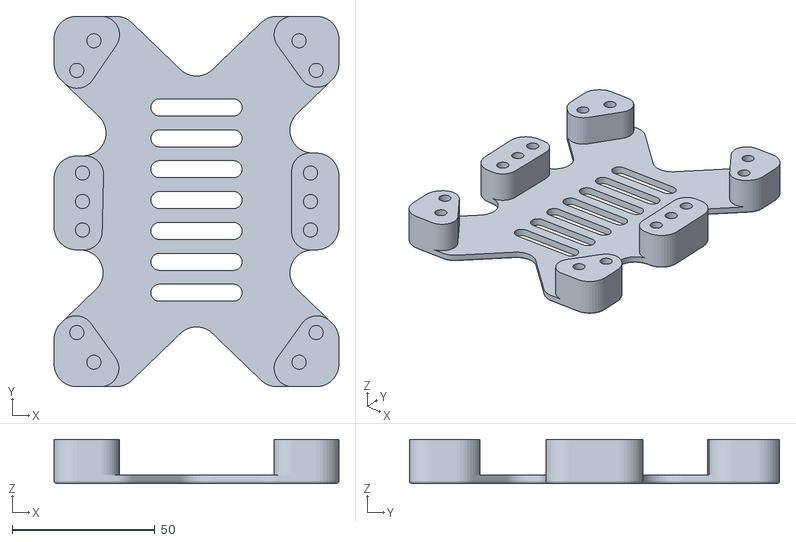
[picture p32: CAD file, 2026-09-05]
CAD/STL(3d printing parts)/battery holder.stl
100.0 x 130.0 x 15.5
