DEFOR111/MADHEX-v2/CAD/STL(3d printing parts)/coxa servo holder 0.stl

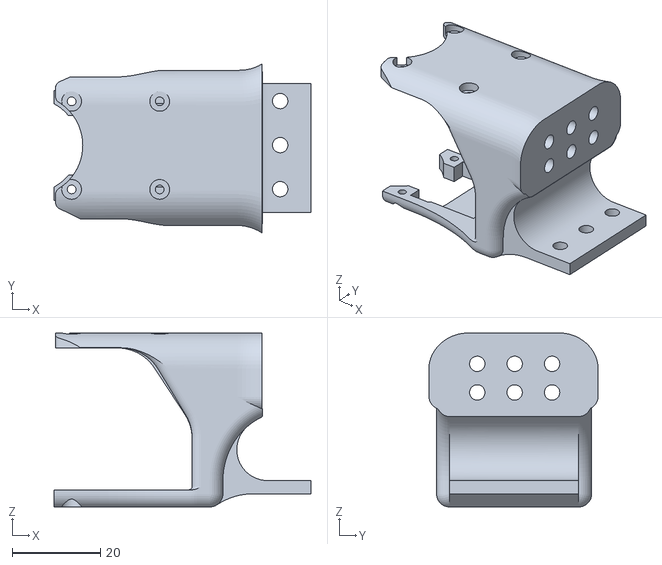
[picture p33: CAD file, 2026-09-05]
CAD/STL(3d printing parts)/coxa servo holder 0.stl
58.4 x 38.4 x 39.5
