DEFOR111/MADHEX-v2/(list of files, cad)

Other CAD files:
CAD/step/MadHex v2(full robot)_.step
mechanics/CAD/Hexapod PCB 2.step
CAD/STL(3d printing parts)/tibia right part.stl
CAD/STL(3d printing parts)/femur right part.stl
CAD/source(f3d)/MadHex v2.f3z
