DEFOR111/MADHEX-v2/Electronics/Hexapod PCB 2.pdf

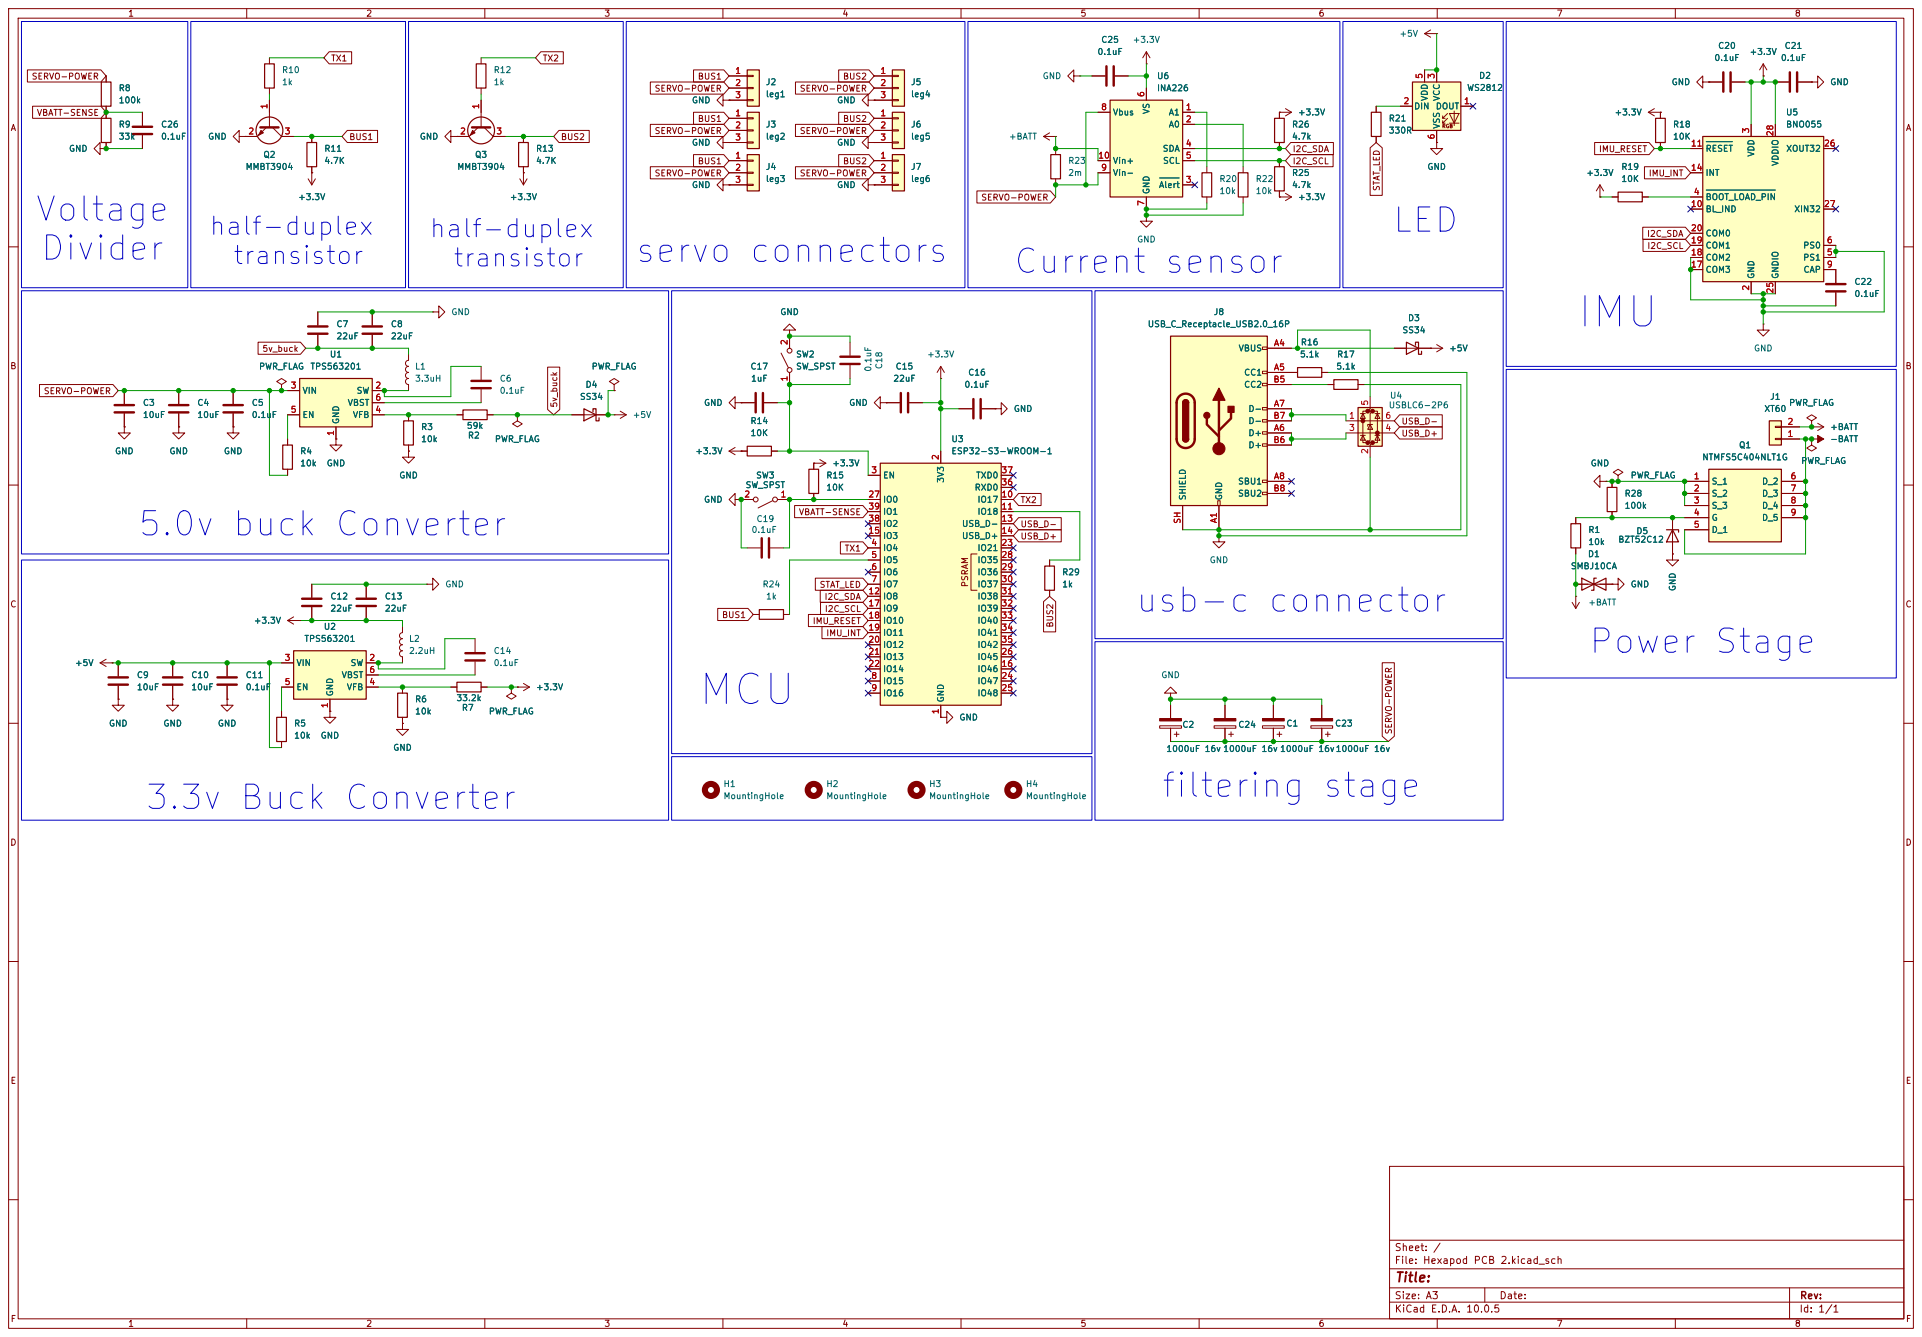
[picture p34: page 1]

Size: A3 | Rev: | F Date:
KiCad E.D.A. 10.0.5 | Id: 1/1
