DEFOR111/MADHEX-v2/Electronics/PCB schematics.pdf

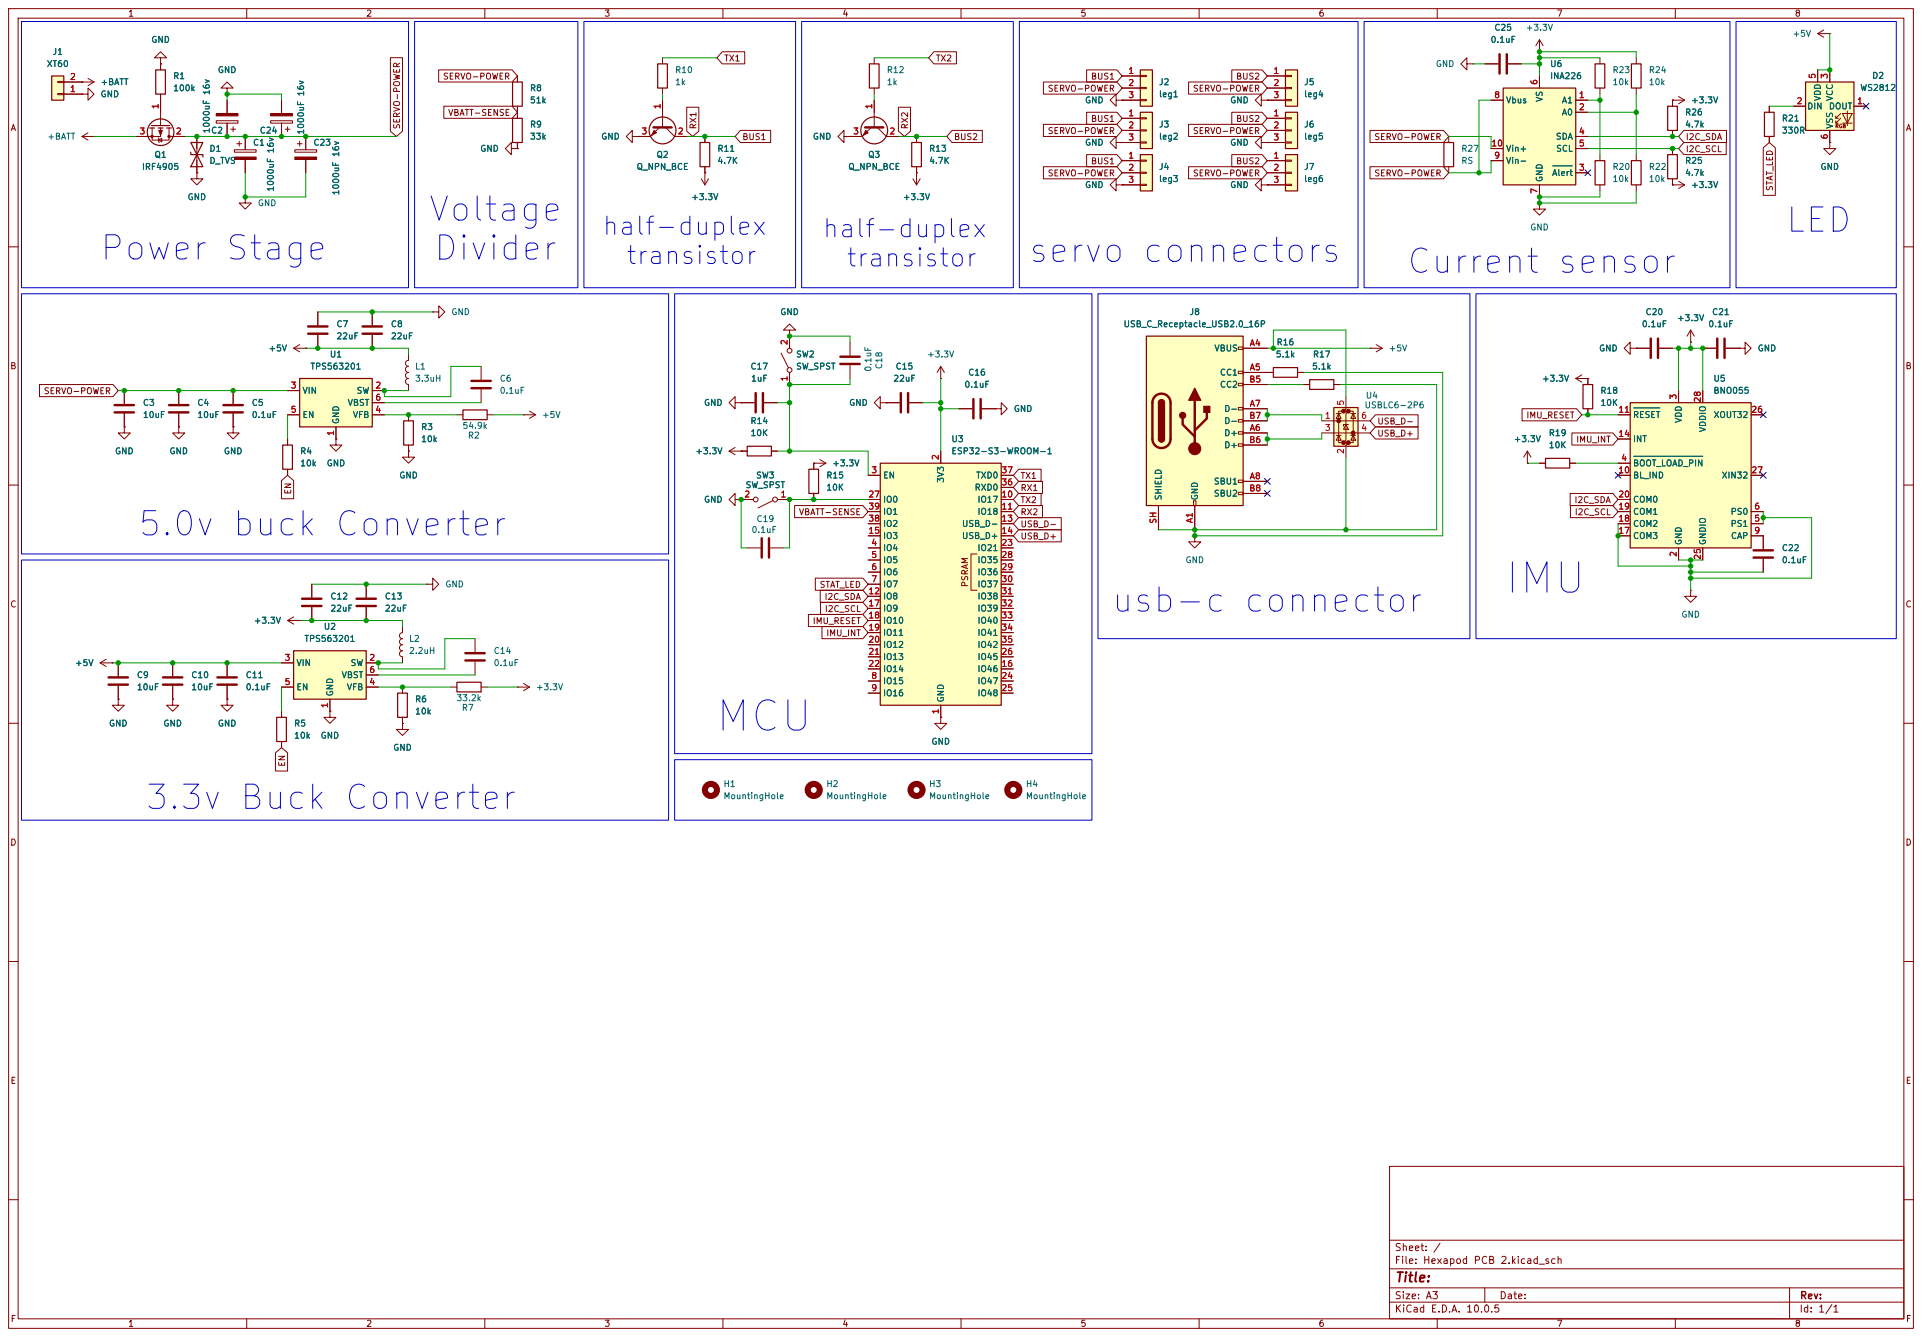
[picture p35: page 1]

Size: A3 | Rev: | F Date:
KiCad E.D.A. 10.0.5 | Id: 1/1
