DEFOR111/MADHEX-v2/Firmware/docs/Hexapod PCB 2 (1).kicad_sch

## KiCad design Firmware/docs/Hexapod PCB 2 (1).kicad_sch (2026-10-10)

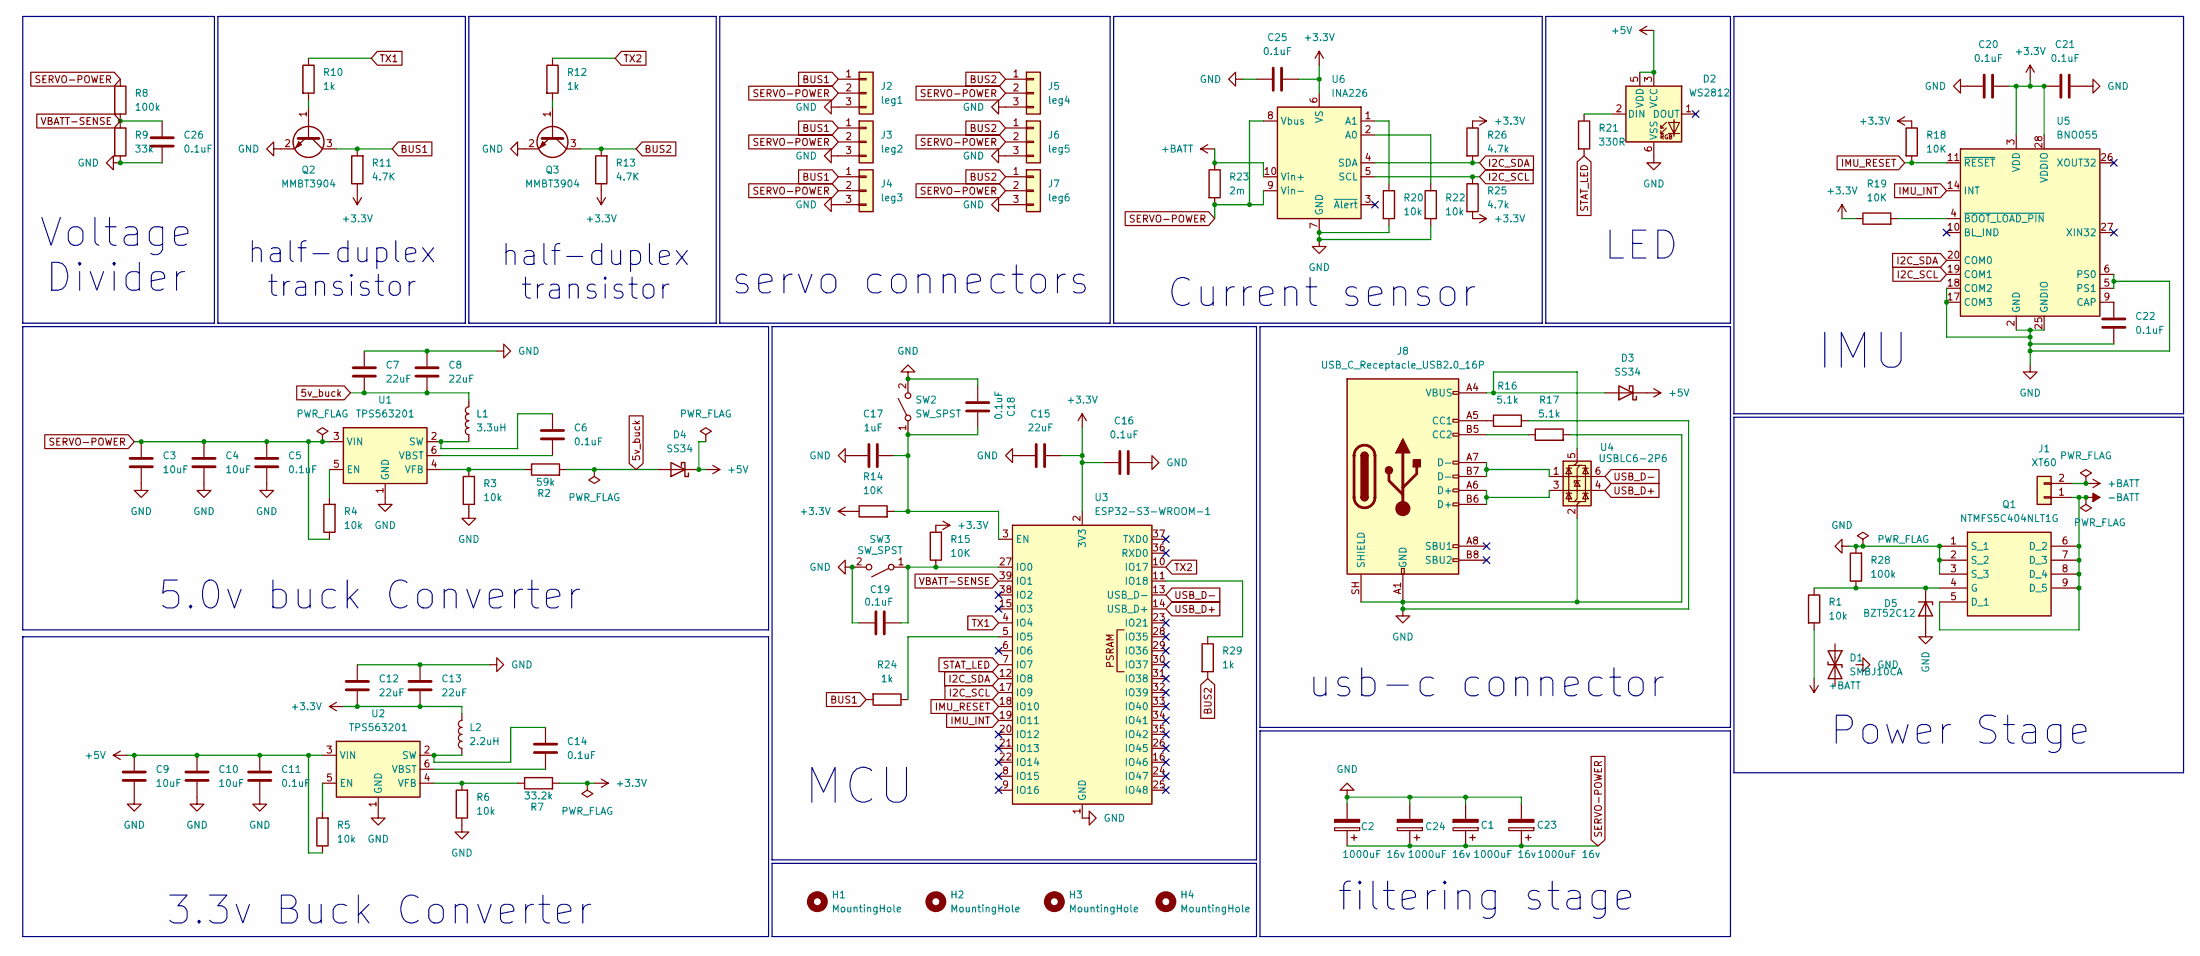
[picture p38: schematic Hexapod PCB 2 (1).kicad_sch]

Parts:
C1, C2, C23, C24: 1000uF 16v; CP_Elec_10x10
C3, C4, C9, C10: 10uF; C_0805_2012Metric
C5, C6, C11, C14, C16, C18, C19, C20, C21, C22, C25, C26: 0.1uF; C_0805_2012Metric
C7, C8, C12, C13, C15: 22uF; C_0805_2012Metric
C17: 1uF; C_0805_2012Metric
D1: SMBJ10CA; D_SMB
D2: WS2812; LED_WS2812_PLCC6_5.0x5.0mm_P1.6mm
D3, D4: SS34; D_SMA
D5: BZT52C12; D_SOD-123
H1, H2, H3, H4: MountingHole; MountingHole_3.2mm_M3
J1: XT60; AMASS_XT60-M_1x02_P7.20mm_Vertical
J2: leg1; JST_XH_B3B-XH-A_1x03_P2.50mm_Vertical
J3: leg2; JST_XH_B3B-XH-A_1x03_P2.50mm_Vertical
J4: leg3; JST_XH_B3B-XH-A_1x03_P2.50mm_Vertical
J5: leg4; JST_XH_B3B-XH-A_1x03_P2.50mm_Vertical
J6: leg5; JST_XH_B3B-XH-A_1x03_P2.50mm_Vertical
J7: leg6; JST_XH_B3B-XH-A_1x03_P2.50mm_Vertical
J8: USB_C_Receptacle_USB2.0_16P; USB_C_Receptacle_HRO_TYPE-C-31-M-12
L1: 3.3uH; L_Bourns-SRN4018
L2: 2.2uH; L_Bourns-SRN4018
Q1: NTMFS5C404NLT1G; NTMFS4C022N; Mouser Part Number 863-NTMFS5C404NLT1G
Q2, Q3: MMBT3904; SOT-23
R1, R3, R4, R5, R6, R20, R22: 10k; R_0805_2012Metric
R2: 59k; R_0805_2012Metric
R7: 33.2k; R_0805_2012Metric
R8, R28: 100k; R_0805_2012Metric
R9: 33k; R_0805_2012Metric
R10, R12, R24, R29: 1k; R_0805_2012Metric
R11, R13: 4.7K; R_0805_2012Metric
R14, R15, R18, R19: 10K; R_0805_2012Metric
R16, R17: 5.1k; R_0805_2012Metric
R21: 330R; R_0805_2012Metric
R23: 2m; R_2512_6332Metric
R25, R26: 4.7k; R_0805_2012Metric
SW2, SW3: SW_SPST; SW_SPST_TS-1088-xR020
U1, U2: TPS563201; SOT-23-6
U3: ESP32-S3-WROOM-1
U4: USBLC6-2P6; SOT-666
U5: BNO055; LGA-28_5.2x3.8mm_P0.5mm
U6: INA226; TSSOP-10_3x3mm_P0.5mm

Connections:
5v_buck: C7.2, C8.2, D4.2 (A), L1.2, R2.2
+3.3V: C12.2, C13.2, C15.2, C16.1, C20.2, C21.1, C25.2, L2.2, R7.2, R11.1, R13.1, R14.1, R15.2, R18.1, R19.1, R25.2, R26.1, U3.2 (3V3), U5.3 (VDD), U5.28 (VDDIO), U6.6 (VS)
+5V: C9.1, C10.1, C11.1, D2.3 (VCC), D2.5 (VDD), D3.1 (K), D4.1 (K), R5.1, U2.3 (VIN)
+BATT: J1.2, R1.2, R23.1, U6.10 (Vin+)
-BATT: J1.1, Q1.5 (D_1), Q1.6 (D_2), Q1.7 (D_3), Q1.8 (D_4), Q1.9 (D_5)
BUS1: J2.1, J3.1, J4.1, Q2.3 (C), R11.2, R24.2
BUS2: J5.1, J6.1, J7.1, Q3.3 (C), R13.2, R29.2
GND: C1.2, C2.2, C3.2, C4.2, C5.2, C7.1, C8.1, C9.2, C10.2, C11.2, C12.1, C13.1, C15.1, C16.2, C17.2, C18.2, C19.2, C20.1, C21.2, C22.1, C23.2, C24.2, C25.1, C26.2, D2.6 (VSS), D5.2 (A), J2.3, J3.3, J4.3, J5.3, J6.3, J7.3, J8.A1 (GND), J8.A12 (GND), J8.B1 (GND), J8.B12 (GND), J8.SH (SHIELD), Q1.1 (S_1), Q1.2 (S_2), Q1.3 (S_3), Q2.2 (E), Q3.2 (E), R3.1, R6.1, R9.2, R16.2, R17.2, R20.2, R22.2, R28.2, SW2.2 (B), SW3.2 (B), U1.1 (GND), U2.1 (GND), U3.1 (GND), U3.40 (GND), U3.41 (GND), U4.2 (GND), U5.2 (GND), U5.5 (PS1), U5.6 (PS0), U5.17 (COM3), U5.18 (COM2), U5.25 (GNDIO), U6.7 (GND)
I2C_SCL: R25.1, U3.17 (IO9), U5.19 (COM1), U6.5 (SCL)
I2C_SDA: R26.2, U3.12 (IO8), U5.20 (COM0), U6.4 (SDA)
IMU_INT: U3.19 (IO11), U5.14 (INT)
IMU_RESET: R18.2, U3.18 (IO10), U5.11 (~RESET)
unnamed: C6.1, U1.6 (VBST)
unnamed: C6.2, L1.1, U1.2 (SW)
unnamed: C14.1, U2.6 (VBST)
unnamed: C14.2, L2.1, U2.2 (SW)
unnamed: C17.1, C18.1, R14.2, SW2.1 (A), U3.3 (EN)
unnamed: C19.1, R15.1, SW3.1 (A), U3.27 (IO0)
unnamed: C22.2, U5.9 (CAP)
unnamed: D2.2 (DIN), R21.1
unnamed: D3.2 (A), J8.A4 (VBUS), J8.A9 (VBUS), J8.B4 (VBUS), J8.B9 (VBUS), U4.5 (VBUS)
unnamed: D5.1 (K), Q1.4 (G), R1.1, R28.1
unnamed: J8.A5 (CC1), R16.1
unnamed: J8.A6 (D+), J8.B6 (D+), U4.3 (I/O2)
unnamed: J8.A7 (D-), J8.B7 (D-), U4.1 (I/O1)
unnamed: J8.B5 (CC2), R17.1
unnamed: Q2.1 (B), R10.2
unnamed: Q3.1 (B), R12.2
unnamed: R2.1, R3.2, U1.4 (VFB)
unnamed: R4.2, U1.5 (EN)
unnamed: R5.2, U2.5 (EN)
unnamed: R6.2, R7.1, U2.4 (VFB)
unnamed: R19.2, U5.4 (~BOOT_LOAD_PIN)
unnamed: R20.1, U6.1 (A1)
unnamed: R22.1, U6.2 (A0)
unnamed: R24.1, U3.5 (IO5)
unnamed: R29.1, U3.11 (IO18)
SERVO-POWER: C1.1, C2.1, C3.1, C4.1, C5.1, C23.1, C24.1, J2.2, J3.2, J4.2, J5.2, J6.2, J7.2, R4.1, R8.1, R23.2, U1.3 (VIN), U6.8 (Vbus), U6.9 (Vin-)
STAT_LED: R21.2, U3.7 (IO7)
TX1: R10.1, U3.4 (IO4)
TX2: R12.1, U3.10 (IO17)
USB_D+: U3.14 (USB_D+), U4.4 (I/O2)
USB_D-: U3.13 (USB_D-), U4.6 (I/O1)
VBATT-SENSE: C26.1, R8.2, R9.1, U3.39 (IO1)

Notes on the sheet:
Current sensor
filtering stage
Power Stage
MCU
Voltage Divider
IMU
LED
servo connectors
usb-c connector
5.0v buck Converter
half-duplex transistor
3.3v Buck Converter
