DEFOR111/MADHEX-v2/(commit log)

2026-08-21 Add KiCad project files and raw file sctructure
2026-08-21 finished the schematics
2026-08-22 finished the schmeatics by redesigning the INA226 , set all of the footprint for the schematics
2026-08-23 first version of placement of the components on the pcb is finished also corrected the footprints and schematics
2026-08-23 finished the layout of the PCB and fixed all DRC mistakes
2026-08-23 added CAD file into the sctructure of the project and added the PCB STEP file
2026-08-25 added some text on the pcb and changed the xt60 from horizontal to vertical mount
2026-09-05 added CAD files added Renders changed the PCB connector footprints added PCB BOM added Hexapod BOM made the project file structure
2026-09-05 renamed the docs into BOM
2026-09-05 made part of Readme
    Corrected the link to the Gerbers and drill files section in the README.
2026-09-05 Revise README for PCB and CAD specifications
    Updated README with enhanced PCB and CAD details, improved formatting, and added links for schematics, manufacturing files, and BOMs.
2026-09-05 Update README with new PCB images and features
    Added additional images and description for the PCB.
2026-09-05 Update BOM links in README.md
2026-10-10 update PCB, BOM, README, add firmware
2026-10-10 Revise README with updated schematics and BOM
    Updated schematic and BOM file links, adjusted component prices, and modified descriptions for clarity.
2026-10-16 Update README overview
    Removed the full assembly guide mention from the overview section.
